jordin-garcia/proyecto_arquitectura_software/2.jpeg

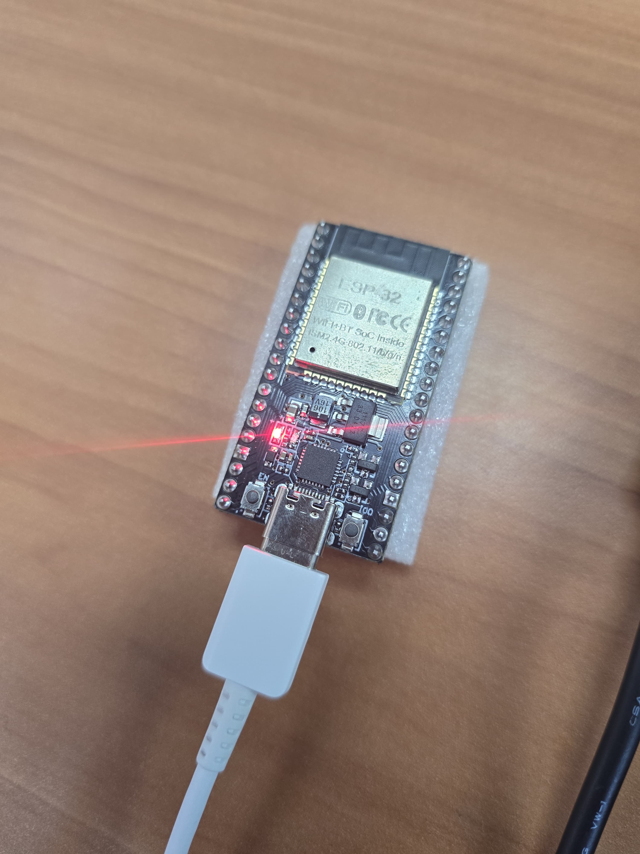
2.jpeg
