jordin-garcia/proyecto_arquitectura_software/web/img/planta.png

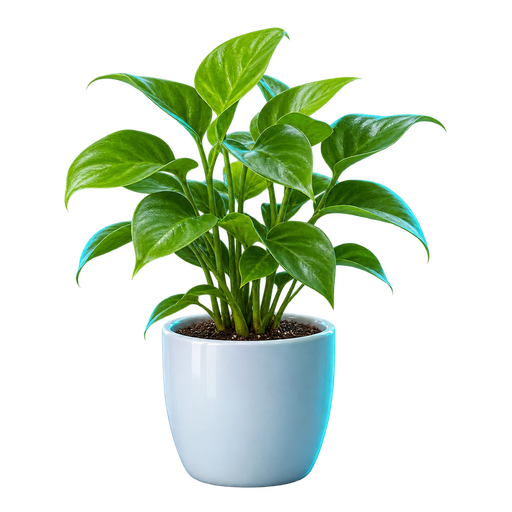
web/img/planta.png
