jordin-garcia/proyecto_arquitectura_software/web/img/sala.jpg

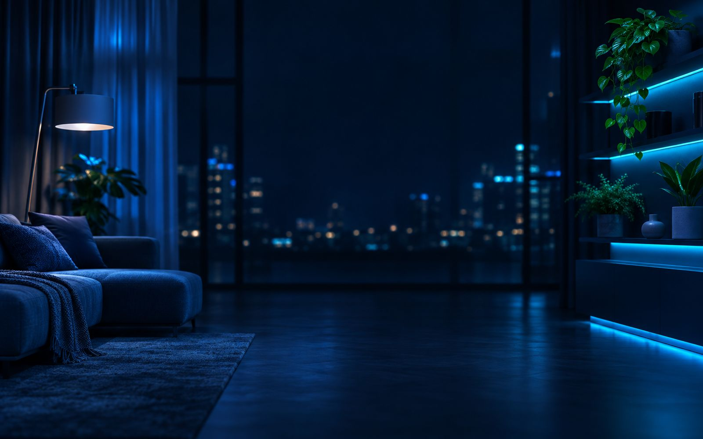
web/img/sala.jpg
