jordin-garcia/proyecto_arquitectura_software/(commit log)

2026-11-09 Cableado real, EMQX, MIA publicada y nueva interfaz
    - Firmware con los pines de la maqueta armada: focos de 120 V por relé
    (interior en GPIO 19, exterior en 22); ventilador, bomba y buzzer por
    transistor; DHT22 en 21, LDR en 34, suelo en 35.
    - Sensores calibrados (suelo 2800-4095, LDR_MAX 1600).
    - ID de cliente MQTT fijo y "online" repetido cada minuto: un último
    deseo atrasado ya no deja la casa como desconectada.
    - Broker MQTT: EMQX Cloud Serverless (HiveMQ dejó de crear brokers gratis).
    - La página considera en línea al ESP32 si recibe su estado.
    - Asistente renombrada a MIA, interfaz rediseñada, órdenes locales sin
    servidor, sonidos y fondo animado.
    - Especificaciones y RE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
    [casa_inteligente.ino, config.h]
2026-11-09 Página ligera en celulares y MIA limitada a sus direcciones
    - Celulares y tabletas: sin vidrio desenfocado, fondo de partículas a 1x
    con menos partículas, y el lienzo ya no se rehace cuando la barra de
    Chrome cambia la altura al deslizar. En Android la pantalla parpadeaba
    en negro y quedaban rectángulos sin dibujar.
    - Servidor de MIA: ORIGEN_PERMITIDO acepta una lista separada por comas
    (página publicada, GitHub Pages y localhost:8080).
    - Direcciones nuevas con el subdominio "sistente".
2026-11-09 Celular: sin drop-shadow en íconos que se redibujan con datos
    En Chrome de Android, el filtro drop-shadow del ícono de un foco encendido
    se pintaba como un rectángulo negro fijo al deslizar o tocar. Se quita en
    celulares y tabletas para los íconos de dispositivos, paneles, escenas,
    conexión y el logo.
2026-11-09 Celular: tarjetas sólidas y micrófono que sí llega a MIA
    - Paneles y tarjetas con colores sólidos en celulares y tabletas: las
    capas semitransparentes se dibujaban con bloques de otro tono en Android.
    - Voz en celulares: ya no se abre el medidor de volumen junto con el
    reconocimiento (Android no comparte el micrófono y el reconocimiento
    recibía silencio). MIA se anima con el texto parcial.
    - El texto reconocido se recalcula con todos los resultados y, si no hay
    resultado final, se usa el último parcial.
2026-11-09 Volver a publicar la página (Cloudflare no compiló ea384e3)
